Velociraptor/RobotArtistGHC18/(commit log)

2018-09-26 Minor cleanup
    * Move sketch into subfolder
    * Rework pen up and pen down functions
    [GHCRobotArtistStarter.ino]
2018-09-28 Swap pen servo direction
    [GHCRobotArtistStarter.ino]
2018-09-28 Add example file for sample drawings
2018-10-08 Include bill of materials for reference
    [BillOfMaterials.csv]
2018-10-08 Add chassis and generator script
2018-10-08 Make chassis untesselated by default
2018-10-08 Added assembly instructions
2018-10-08 Reference Arduino IDE in Readme
2018-10-08 Update README with assembly instructions link
